Borrajo/Orbit-Controller-ESP32-S3/Firmware/Configuration.png

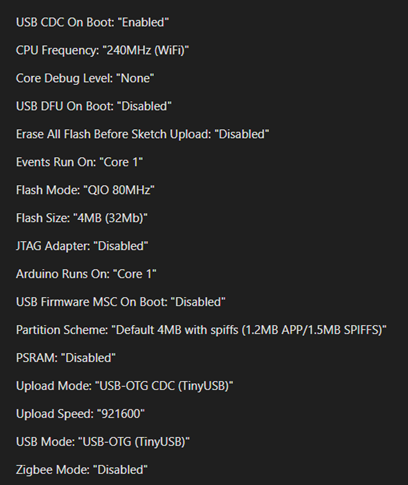
Firmware/Configuration.png
