Borrajo/Orbit-Controller-ESP32-S3/Wiring/wiring.png

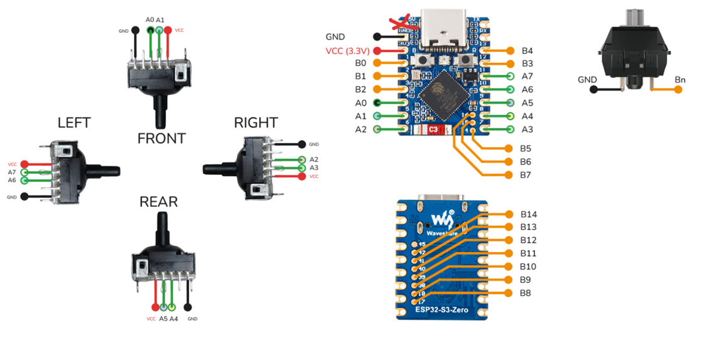
Wiring/wiring.png
