Borrajo/Orbit-Controller-ESP32-S3/(commit log)

2026-07-04 Allow configurable multi-axis movement filtering
2026-07-13 Add support for ESP32-S3
